serhii-matsyshyn/biolistener_hardware/README.md

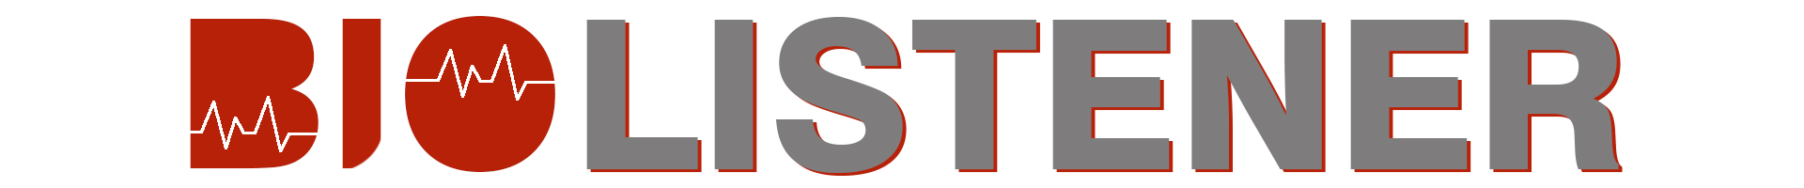
[picture p1: data/images/BioListener_Logo_1920х200.jpg]
BioListener Logo


# BioListener Hardware

This repository contains all the necessary files related to the **BioListener project** hardware design, including **PCB source files**, **schematic files**, **PCB layer visuals**, **fabrication files**, **BOM files**, and  **interactive BOM files**. The hardware designs are created in [EasyEDA](https://easyeda.com/), ensuring easy access and modification for further development.

## Evaluated Boards
The following boards are evaluated and tested as part of the BioListener project:

- **ADC AD7771** (Analog Devices)
- **ADC ADS131M08** (Texas Instruments)

## Included PCBs
### V1.0
Initial version of the BioListener boards.
- [**BioListener ADC AD7771-based Board v1.0**](hardware/pcb/V1.0/AD7771_V1.0) - 4 layer PCB
- [**BioListener ADC ADS131M08-based Board v1.0**](hardware/pcb/V1.0/ADS131M08_V1.0) - 4 layer PCB

### V1.1
Updated version of the BioListener boards. Changes: added voltage supervisor, minor improvements.
- [**BioListener ADC AD7771-based Board v1.1**](hardware/pcb/V1.1/AD7771_V1.1) - 4 layer PCB
- [**BioListener ADC ADS131M08-based Board v1.1**](hardware/pcb/V1.1/ADS131M08_V1.1) - 4 layer PCB

See schematic and PCB layer visuals in the PCBs folders as PDF documents.

## Included PCB Drafts
- **BioListener Stimulation Board v1.0** (Draft) - 4 layer PCB

### BioListener Boards v1.0

#### Ready PCBs (Prototypes)
<p align="center">
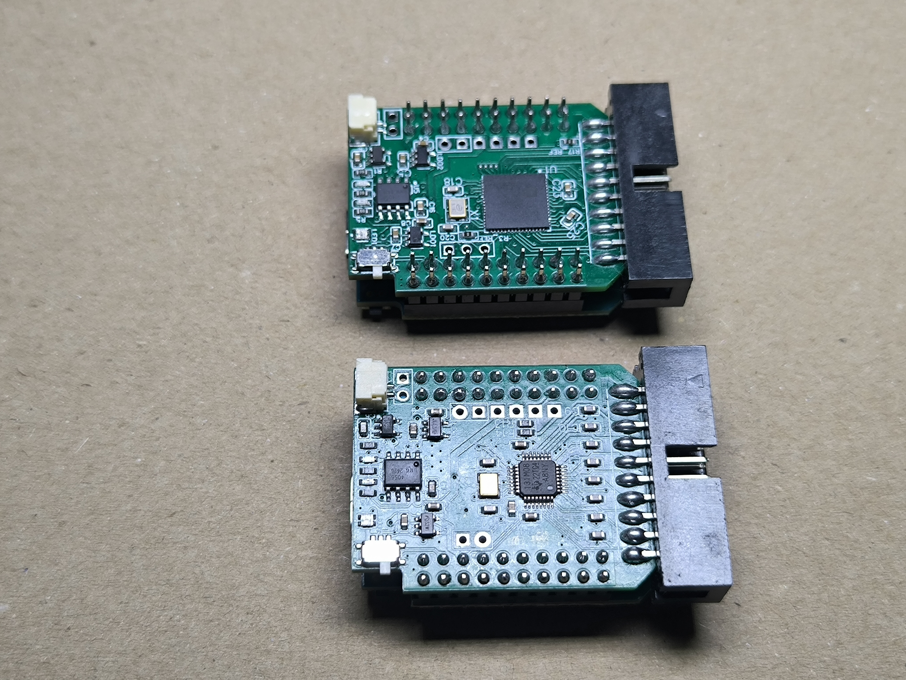
[picture p2: data/images/BioListener_boards_v1.0_prototypes.jpg]
BioListener Boards v1.0
  
</p>

<p align="center">
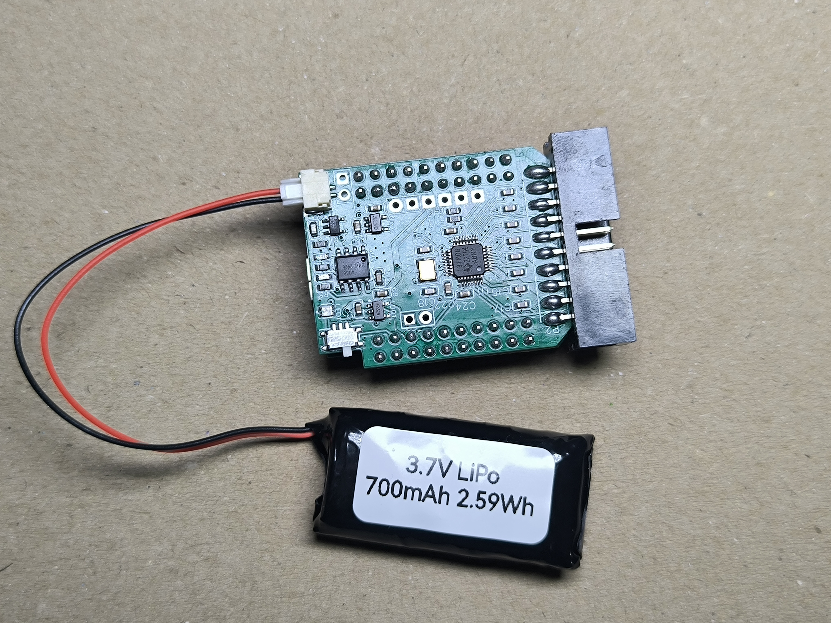
[picture p3: data/images/BioListener_boards_v1.0_prototypes_battery.jpg]
BioListener Boards v1.0
  
</p>

<p align="center">
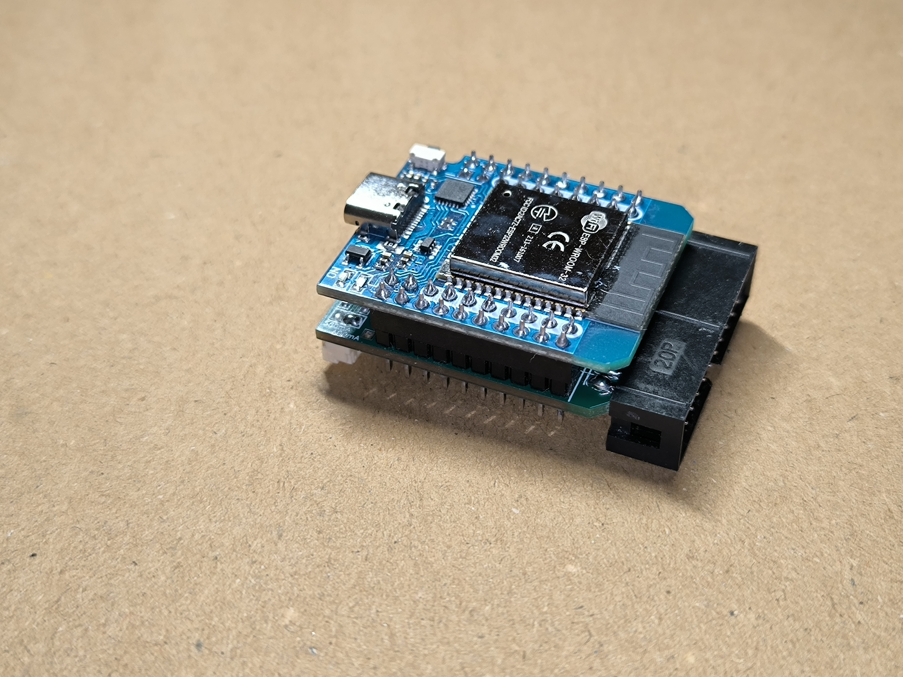
[picture p4: data/images/BioListener_boards_v1.0_esp32_prototypes.jpg]
BioListener Boards v1.0
  
</p>

#### Manual Assembly Process

| Step | Image |
|---|---|
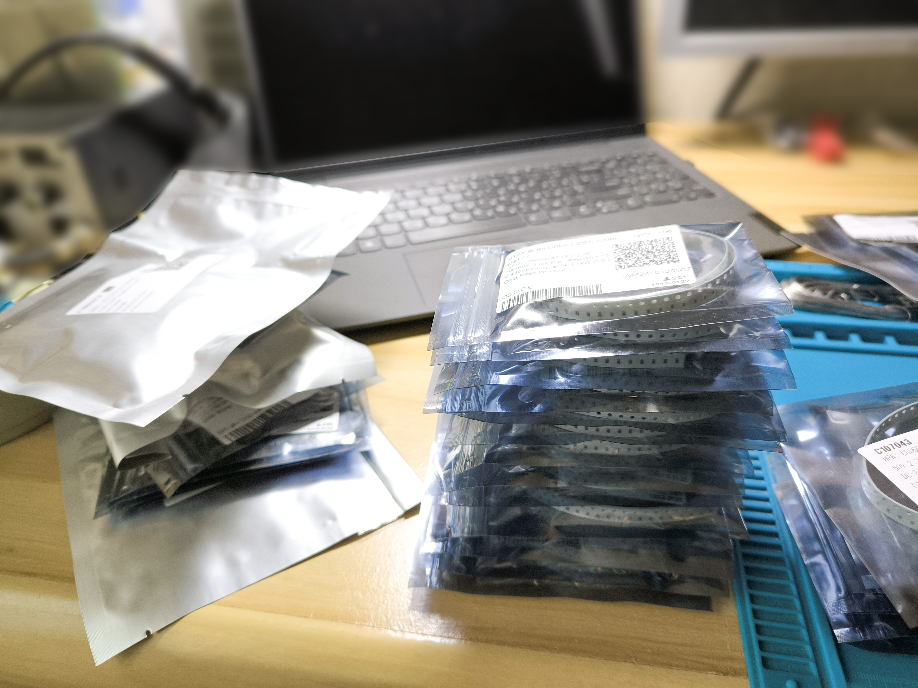
[picture p5: data/images/BioListener_pcb_components_1.jpg]
Components
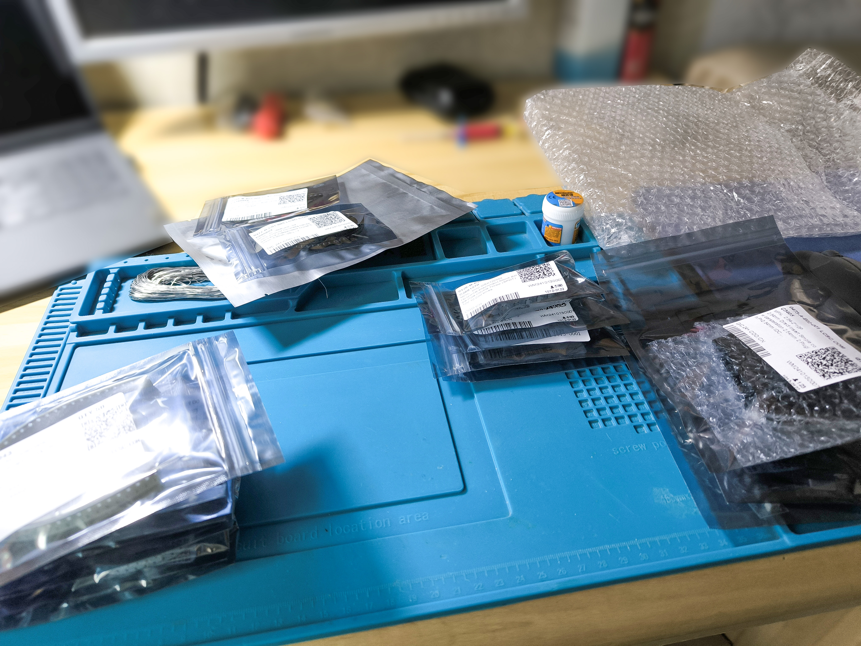
[picture p6: data/images/BioListener_pcb_components_2.jpg]
Components
| **1. Components** |   |
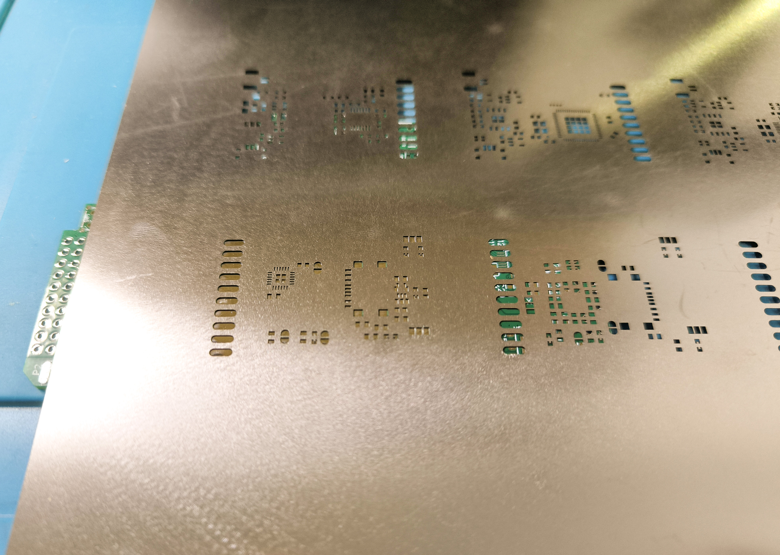
[picture p7: data/images/BioListener_pcb_stencil_1.jpg]
Stencil
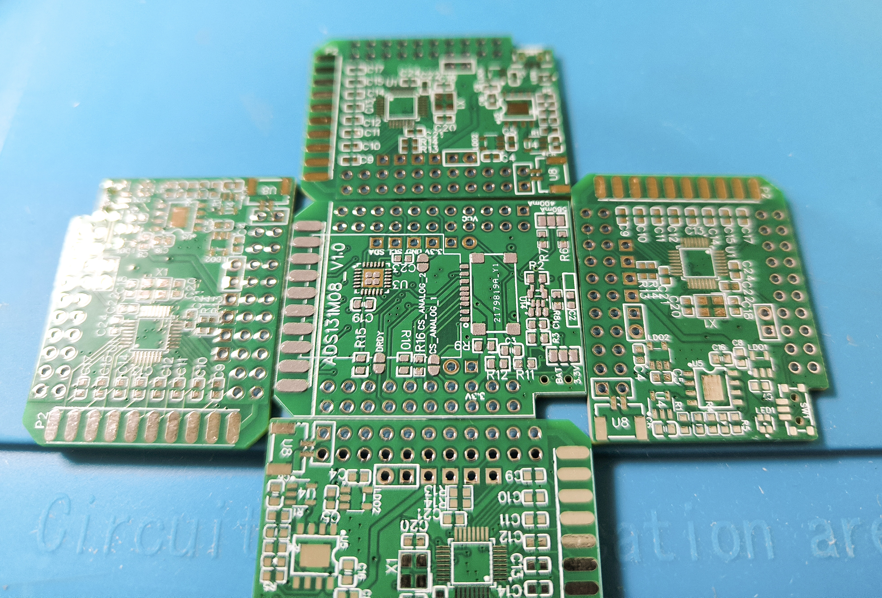
[picture p8: data/images/BioListener_pcb_stencil_2.jpg]
Stencil
| **2. Stencil, <br>Solder Paste applied** |   |
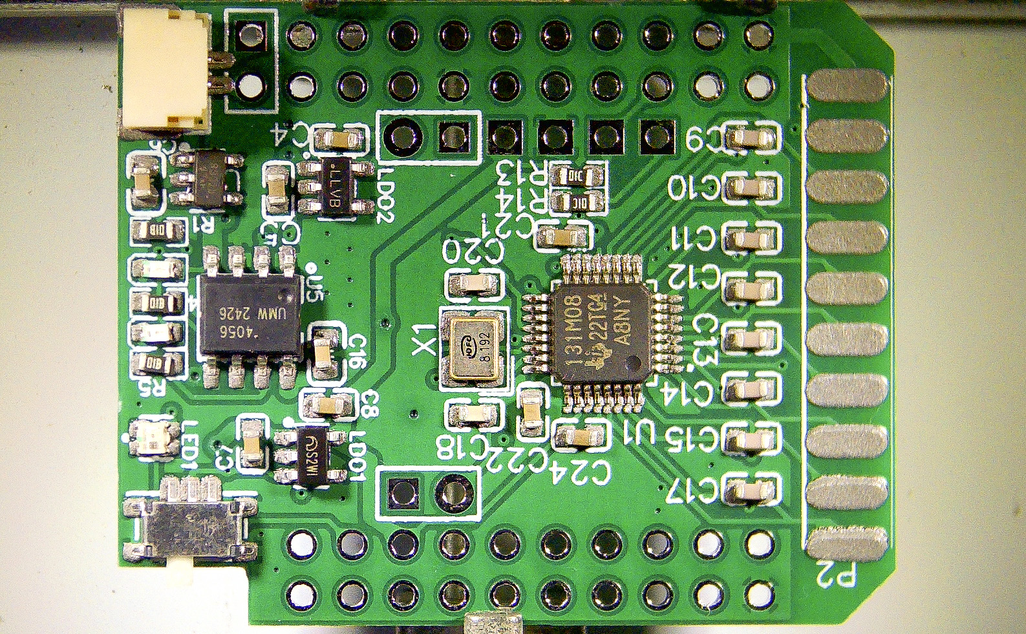
[picture p9: data/images/BioListener_pcb_populating.jpg]
Populating
| **3. Populating Under Microscope, <br>Hot Air Soldering** |  |
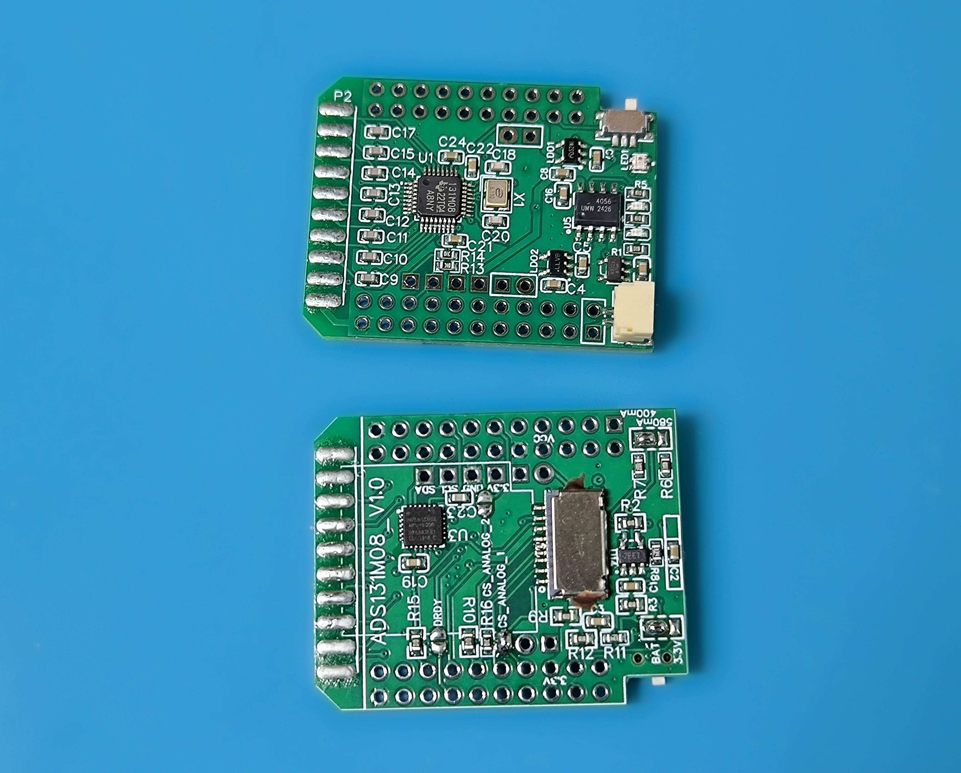
[picture p10: data/images/BioListener_pcb_ready.jpg]
Ready Boards
| **5. SMD Components Soldered** |  |
| **6. THD Connectors Soldered, <br>Boards Are Ready** | Ready Boards |

## License

This repository uses the following licenses:
- **Hardware design files** - The hardware design files in this repository are licensed under the **CERN Open Hardware Licence, Version 2 - Strongly Reciprocal**.
