serhii-matsyshyn/biolistener_hardware/hardware/pcb/V1.1/AD7771_V1.1/production/BOM_EEG_main_ad7771_2025-03-14.csv

ID | Name | Designator | Footprint | Quantity | Manufacturer Part | Manufacturer | Supplier | Supplier Part | Price
1 | 100n | C3,C6,C9,C12,C13,C15,C16,C22,C23,C25,C26,C28,C30,C32,C34 | C_0603 | 15 | CC0603KRX7R9BB104 | YAGEO | LCSC | C14663 | 0.002
2 | 1uF | C4,C5,C7,C8,C10,C11,C14,C17,C19,C27,C29,C31,C35 | C0603 | 13 | CL10A105KO8NNNC | SAMSUNG(三星) | LCSC | C1592 | 0.003
3 | 10pF | C18,C20 | C0603 | 2 | 0603CG100J500NT | FH(风华) | LCSC | C91367 | 0.003
4 | ME6211C33M5G-N | LDO1 | SOT-23-5_L3.0-W1.7-P0.95-LS2.8-BL | 1 | ME6211C33M5G-N | MICRONE(南京微盟) | LCSC | C82942 | 0.048
5 | LP5907MFX-3.3/NOPB | LDO2 | SOT-23-5_L3.0-W1.7-P0.95-LS2.8-BR | 1 | LP5907MFX-3.3/NOPB | TI(德州仪器) | LCSC | C80670 | 0.102
6 | XL-1615RGBC-WS2812B | LED1 | LED-SMD_4P-L1.6-W1.5_XL-1615RGBC-WS2812B | 1 | XL-1615RGBC-WS2812B | XINGLIGHT(成兴光) | LCSC | C5349954 | 0.049
7 | GREEN | LED5 | LED0603-RD_GREEN | 1 | XL-1608UGC-04 | XINGLIGHT(成兴光) | LCSC | C965804 | 0.005
8 | RED | LED6 | LED0603-RD_RED | 1 | XL-1608SURC-06 | XINGLIGHT(成兴光) | LCSC | C965799 | 0.003
9 | HDR-IDC-2.54-2X10P | P2 | EDGECONNECTOR_10X2X2.54 | 1 | IDC Box 2.54mm 2X10P Straight | BOOMELE | LCSC | C3405 | 0.119
10 | 1kΩ | R1,R4,R5 | R0603 | 3 | 0603WAF1001T5E | UNI-ROYAL(厚声) | LCSC | C21190 | 0.001
11 | 0Ω | R2_REF,R3_REF,R17_REF | R0603 | 3 | 0603WAF0000T5E | UNI-ROYAL(厚声) | LCSC | C21189 | 0.001
12 | 2kΩ | R6 | R0603 | 1 | 0603WAF2001T5E | UNI-ROYAL(厚声) | LCSC | C22975 | 0.001
13 | 3kΩ | R7 | R0603 | 1 | 0603WAF3001T5E | UNI-ROYAL(厚声) | LCSC | C4211 | 0.001
14 | 100k | R9,R10,R12,R15,R17 | 0603 | 5 | 0603WAF1003T5E | UNI-ROYAL(厚声) | LCSC | C25803 | 0.001
15 | 330kΩ | R11 | R0603 | 1 | 0603WAF3303T5E | UNI-ROYAL(厚声) | LCSC | C23137 | 0.001
16 | 10kΩ | R13,R14,R16 | R0603 | 3 | 0603WAF1002T5E | UNI-ROYAL(厚声) | LCSC | C25804 | 0.001
17 | MINI MSK12CO2 | SW1 | SW-SMD_MSK12CO2 | 1 | MINI MSK12CO2 | SHOU HAN(首韩) | LCSC | C2681570 | 0.141
18 | AD7771BCPZ-RL | U1 | LFCSP-64_L9.0-W9.0-P0.50-BL-EP7.5 | 1 | AD7771BCPZ-RL | ADI(亚德诺) | LCSC | C651536 | 17.039
19 | RY2201 | U4 | SOT-23-5_L3.0-W1.7-P0.95-LS2.8-BL | 1 | RY2206 | RYCHiP(蕊源) | LCSC | C2935408 | 0.087
20 | TP4056_C725790 | U5 | ESOP-8_L4.9-W3.9-P1.27-LS6.0-BL-EP | 1 | TP4056 | UMW(友台半导体) | LCSC | C725790 | 0.067
21 | TF-123-ARP9H17 | U7 | TF-SMD_TF-123-ARP9H15 | 1 | TF-123-ARP9H17 | XUNPU(讯普) | LCSC | C2982548 | 0.092
22 | SM02B-GHS-TB(LF)(SN) | U8 | CONN-SMD_SM02B-GHS-TB-LF-SN | 1 | SM02B-GHS-TB(LF)(SN) | JST | LCSC | C189893 | 0.096
23 | MAX809T | U11 | SOT-23-3_L2.9-W1.3-P1.90-LS2.4-BR | 1 | MAX809T | UMW(友台半导体) | LCSC | C347372 | 0.041
24 | 8.192MHz | X1 | CRYSTAL-SMD_4P-L3.2-W2.5-BL | 1 | 7B008192I01 | HD(浩都频率) | LCSC | C648988 | 0.161
