serhii-matsyshyn/biolistener_hardware/hardware/pcb/V1.1/ADS131M08_V1.1/Schematic_BioListener_ads131m08_v1.0.pdf

SM02B-GHS-TB(LF)(SN)

## OR MCP6V31UT-E/OT

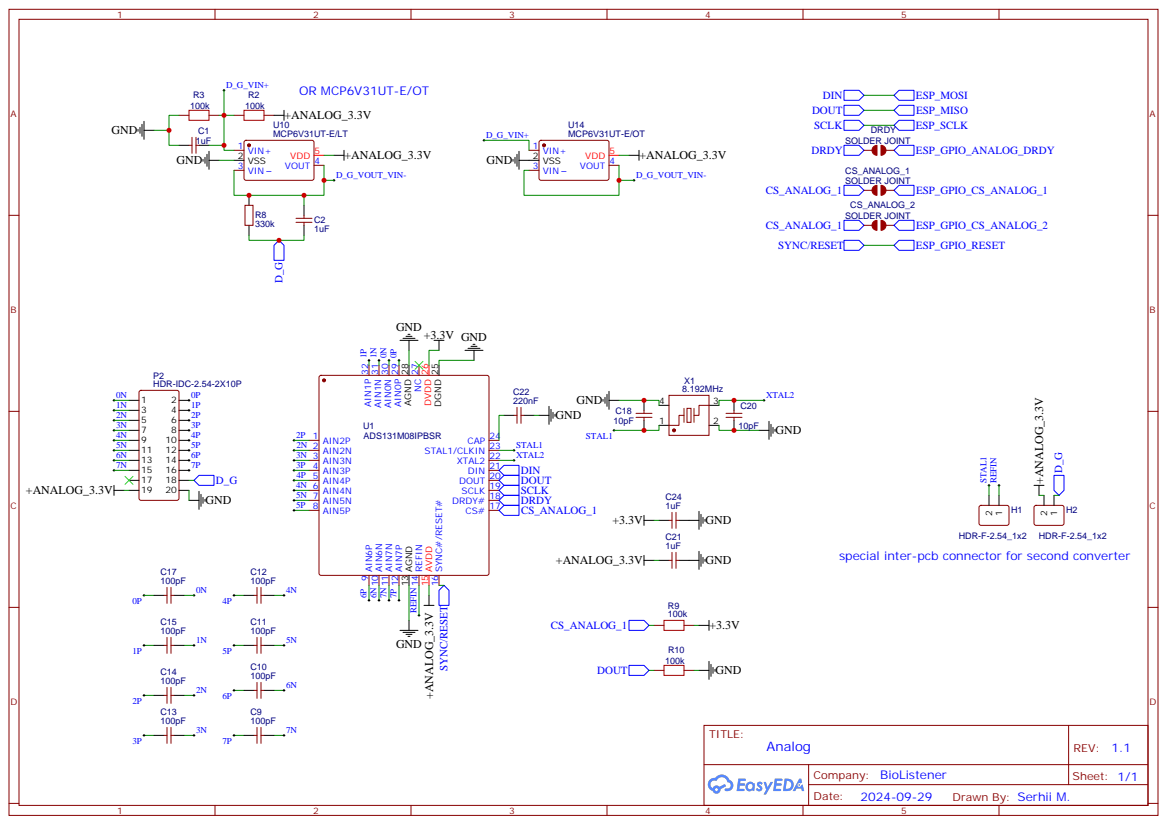
[picture p18: page 2]

CS# 17 DRDY# 18 SCLK 19 DOUT 20 DIN 21 XTAL2 22 STAL1/CLKIN 23 CAP 24 DGND ²⁵ DVDD ²⁶

special inter-pcb connector for second converter

## EMPTY

## EMPTY EMPTY

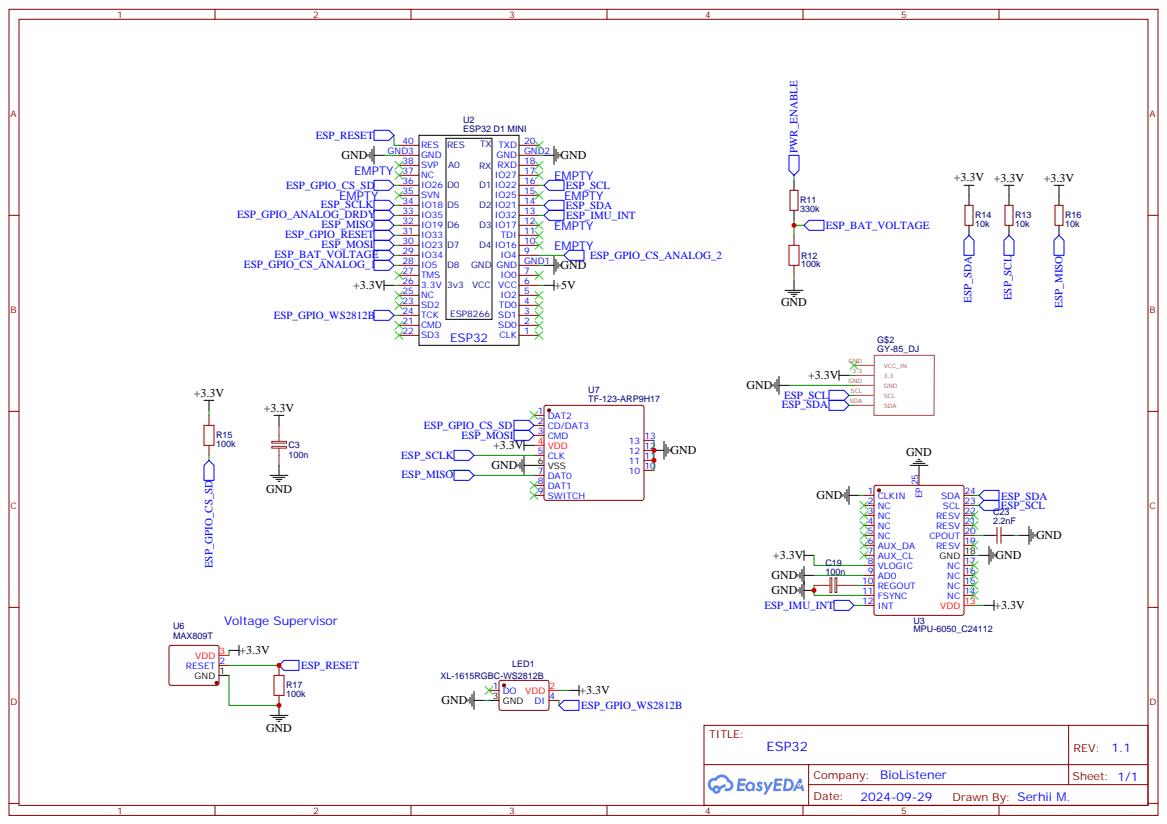
[picture p19: page 3]
