serhii-matsyshyn/biolistener_hardware/hardware/pcb/V1.1/ADS131M08_V1.1/pcb_layer_visuals/BottomSolderMaskLayer.pdf

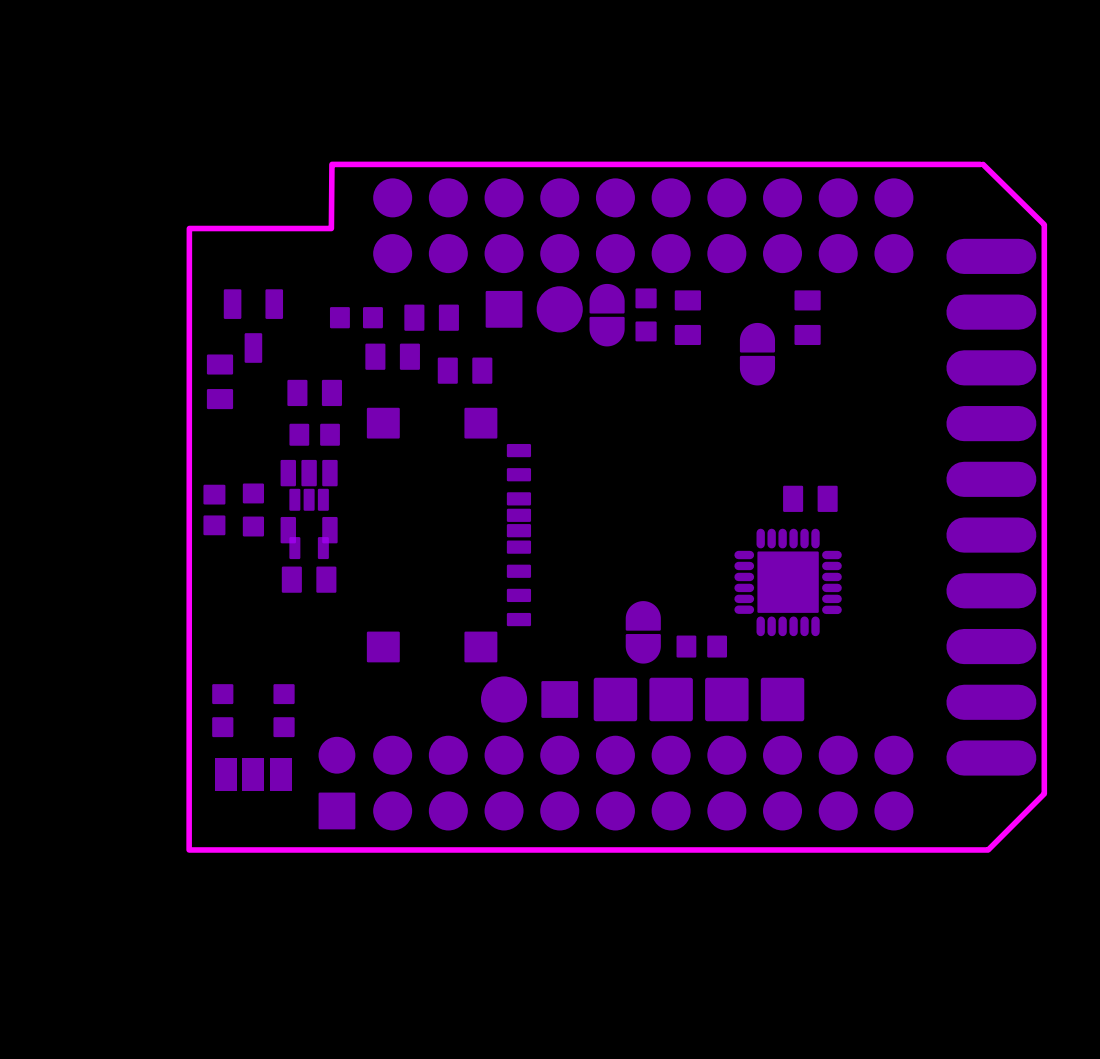
[picture p23: page 1]
