serhii-matsyshyn/biolistener_hardware/hardware/pcb/V1.0/AD7771_V1.0/Schematic_BioListener_ad7771_v1.0.pdf

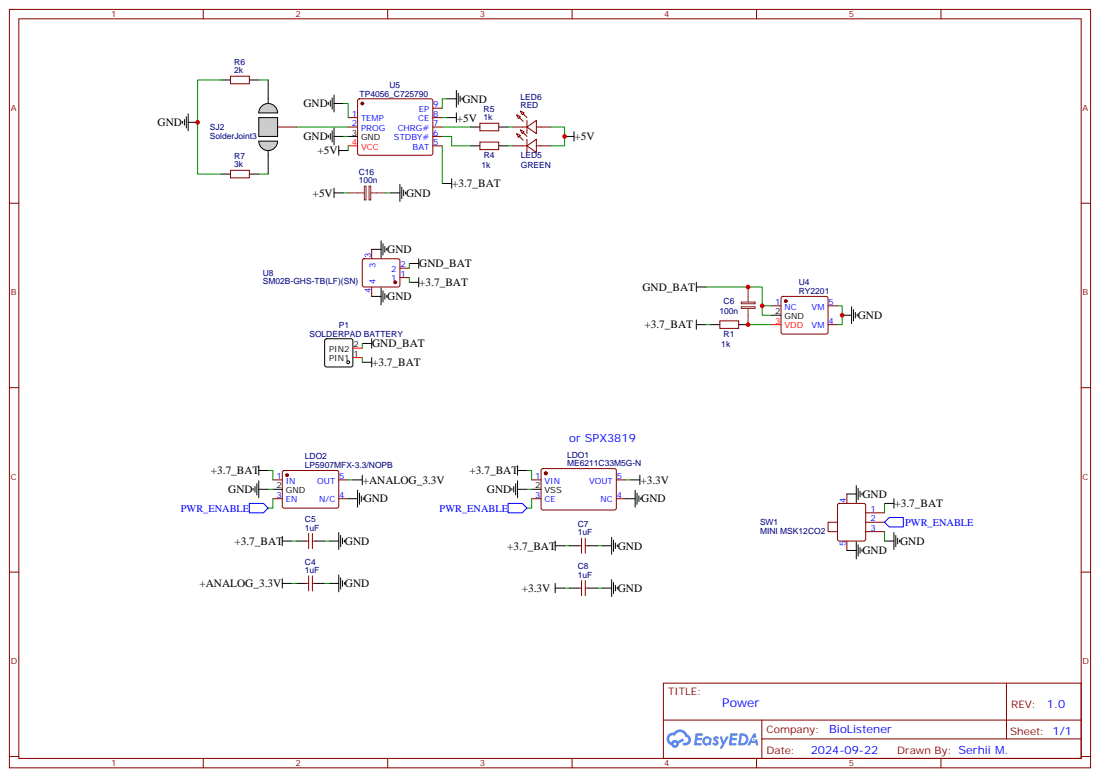
[picture p30: page 1]

SM02B-GHS-TB(LF)(SN)

# ESP_GPIO_CS_ANALOG_2 +ANALOG_3.3V

## External crystal generate

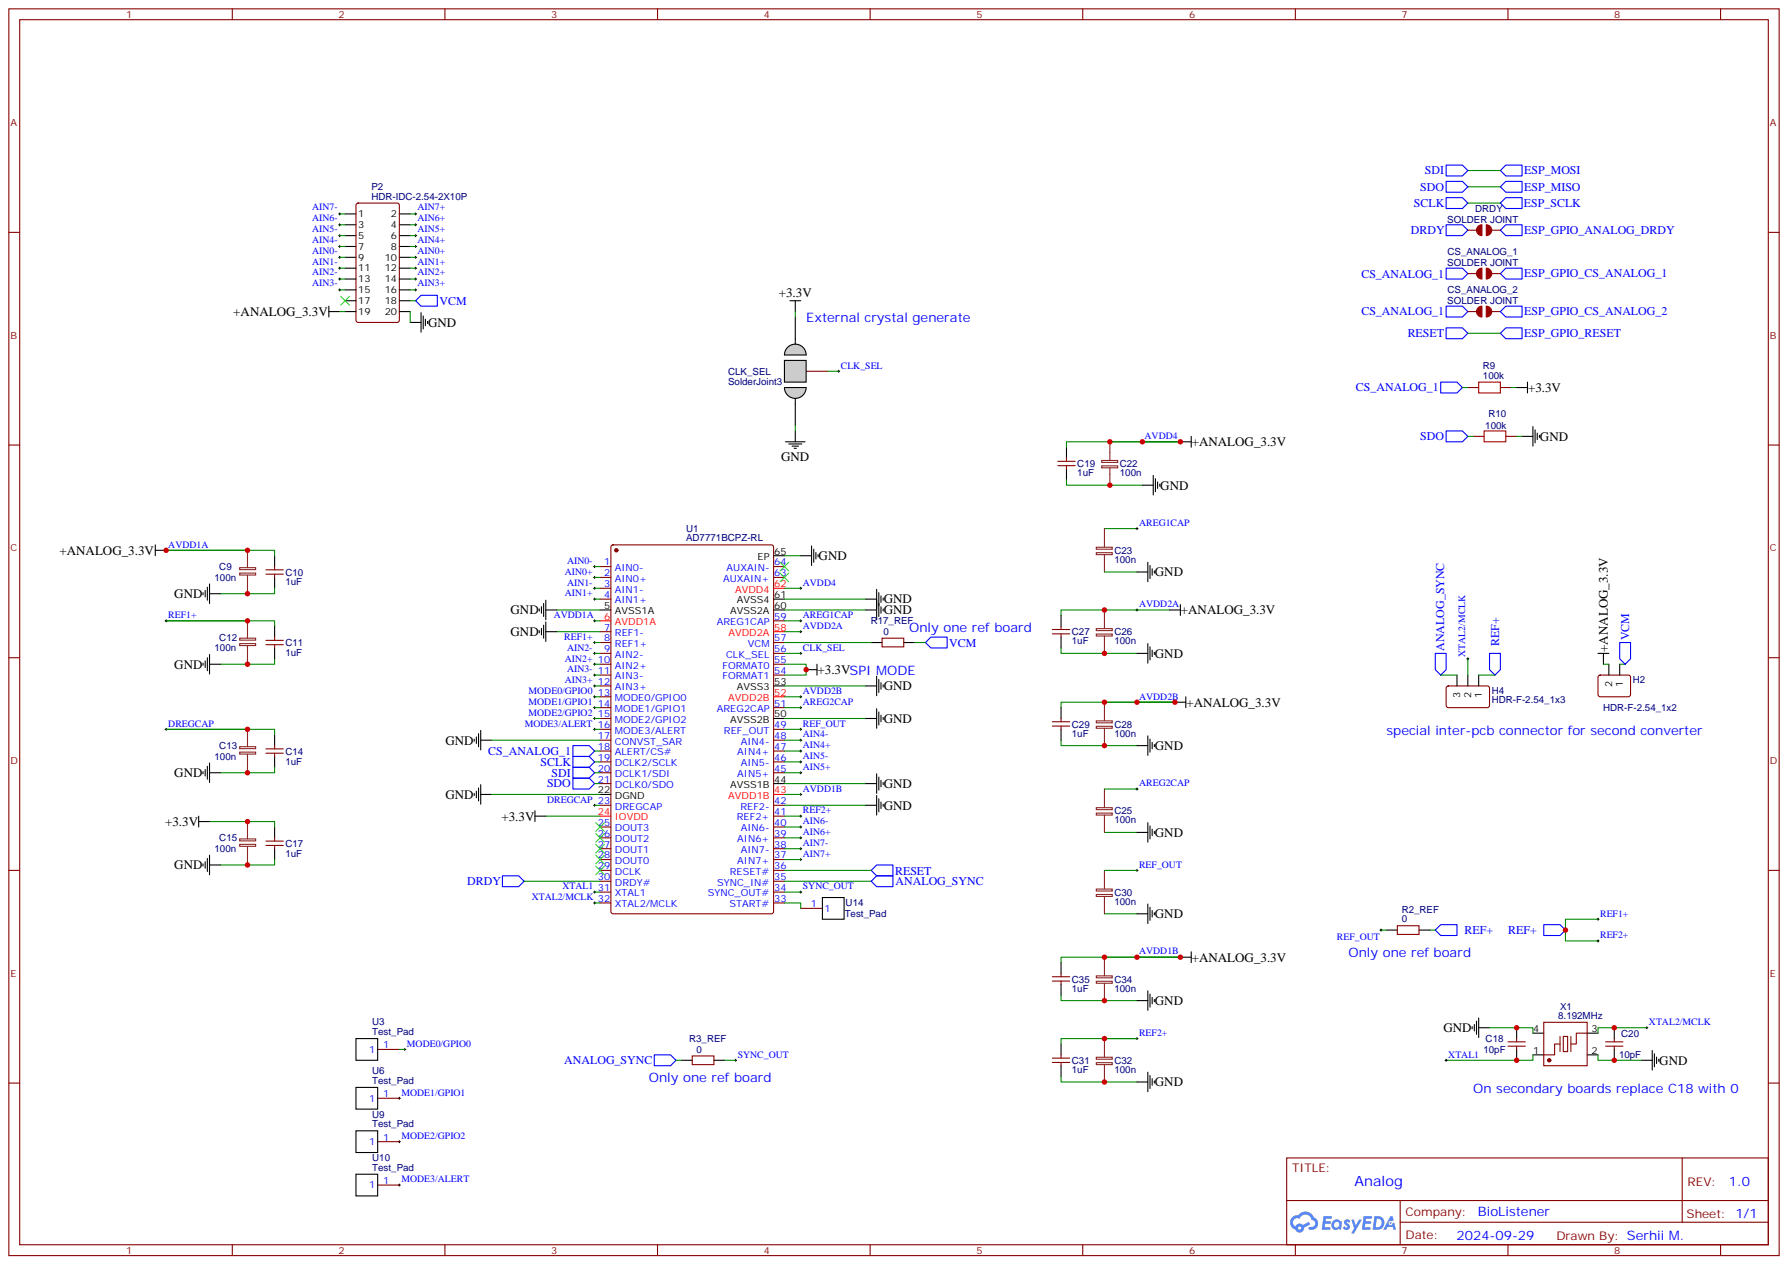
[picture p31: page 2]

special inter-pcb connector for second converter

REF_OUT
Only one ref board

On secondary boards replace C18 with 0

## EMPTY

## EMPTY

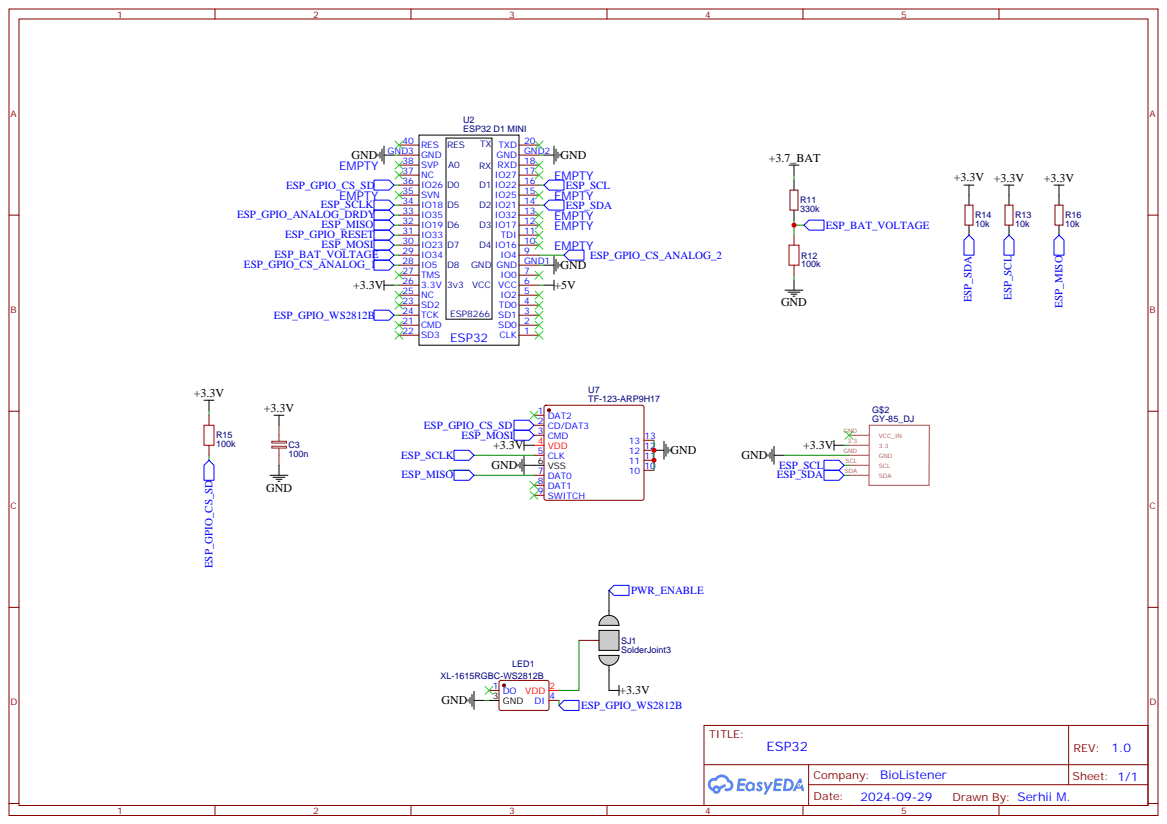
[picture p32: page 3]
