serhii-matsyshyn/biolistener_hardware/hardware/pcb/V1.0/ADS131M08_V1.0/Schematic_BioListener_ads131m08_v1.0.pdf

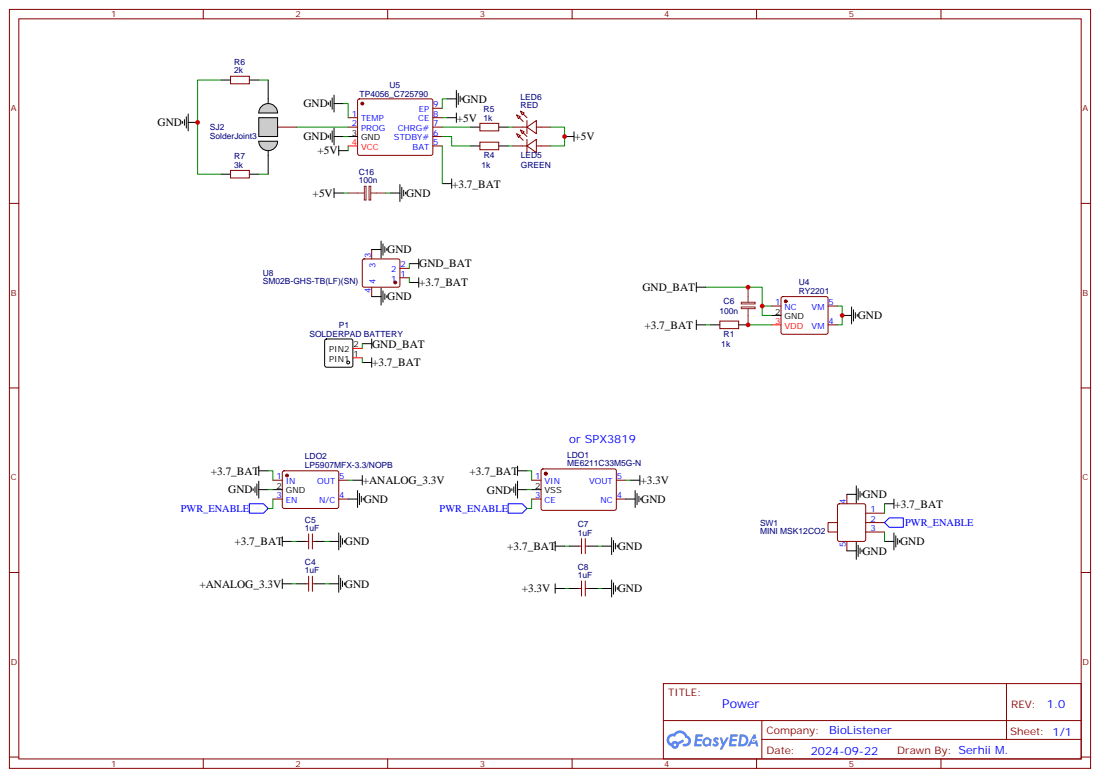
[picture p33: page 1]

SM02B-GHS-TB(LF)(SN)

## OR MCP6V31UT-E/OT

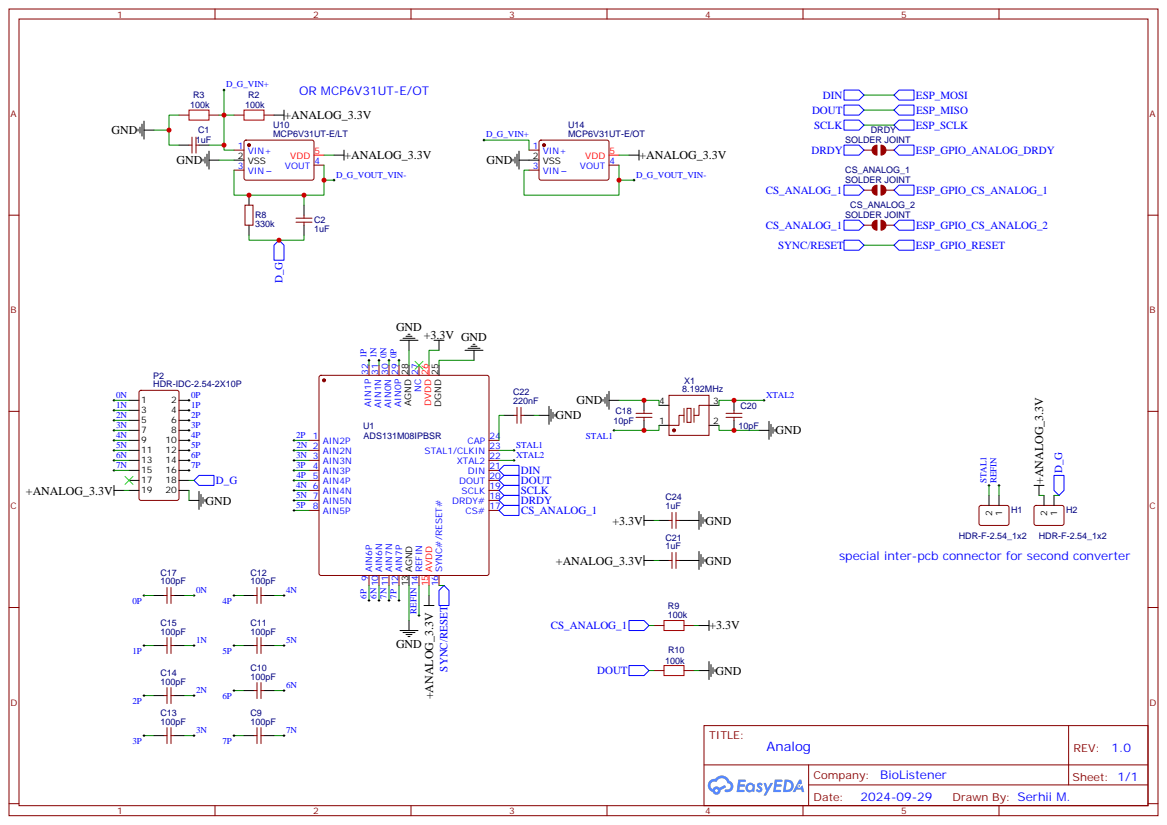
[picture p34: page 2]

CS# 17 DRDY# 18 SCLK 19 DOUT 20 DIN 21 XTAL2 22 STAL1/CLKIN 23 CAP 24 DGND ²⁵ DVDD ²⁶

special inter-pcb connector for second converter

## EMPTY

## EMPTY

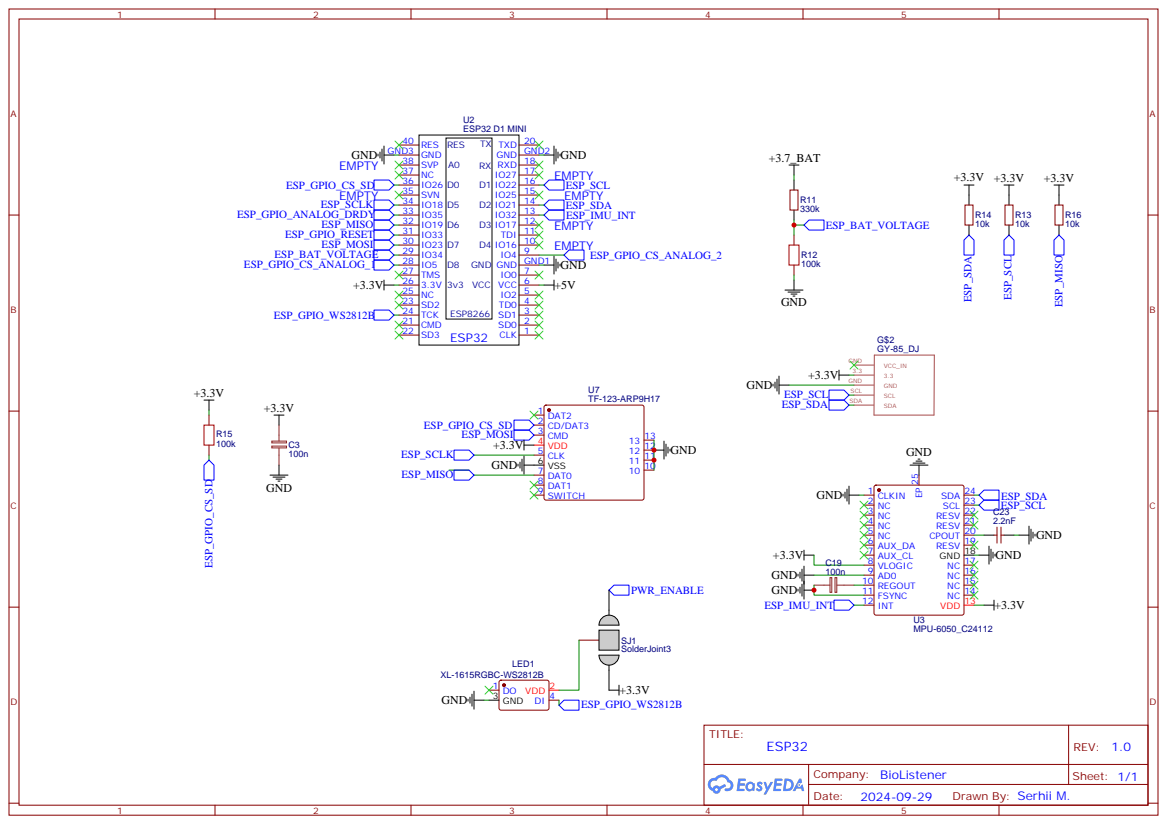
[picture p35: page 3]
