serhii-matsyshyn/biolistener_hardware/hardware/pcb/V1.0/STIMULATION_V1.0/pcb_layer_visuals/BottomLayer.pdf

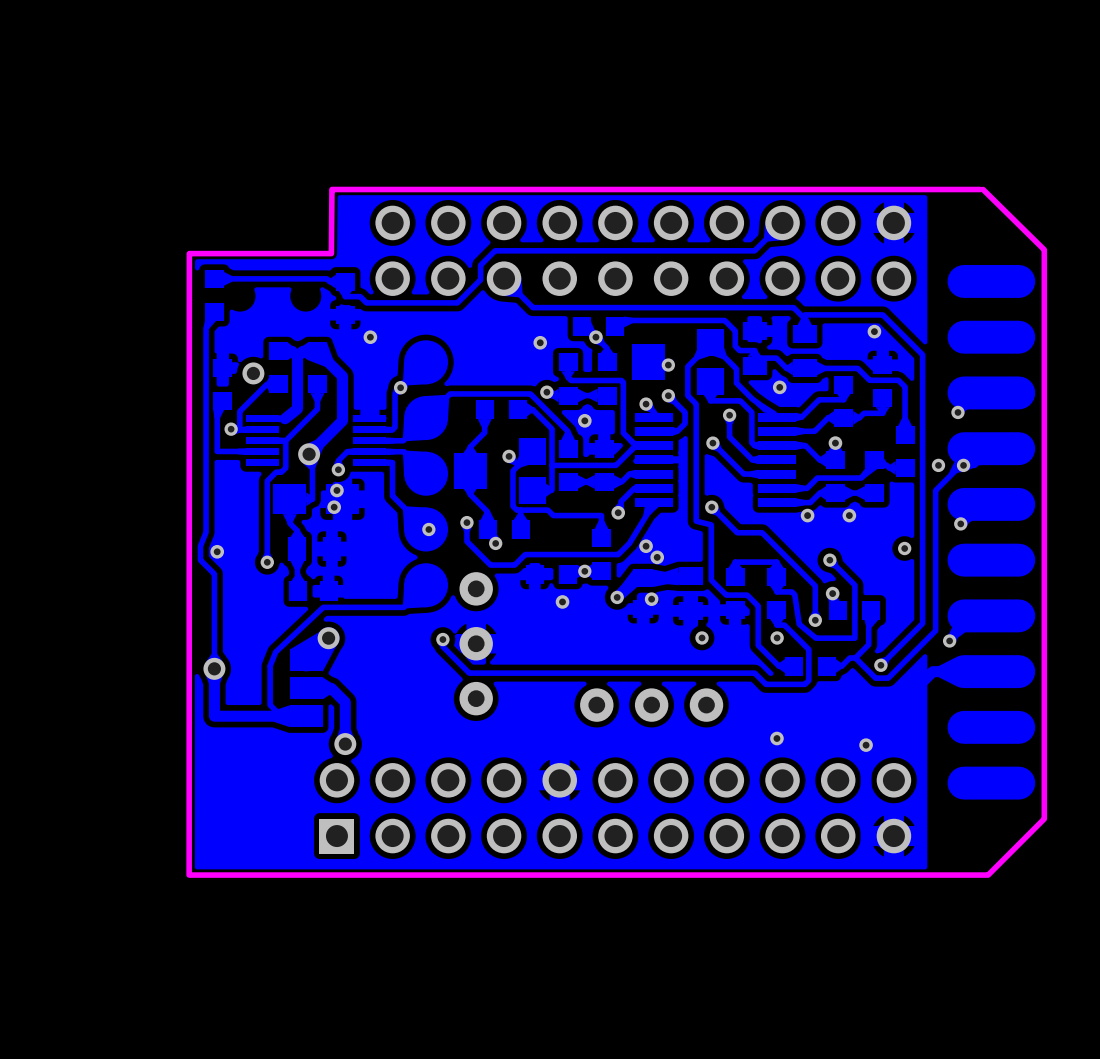
[picture p36: page 1]
