serhii-matsyshyn/biolistener_hardware/hardware/pcb/V1.0/STIMULATION_V1.0/pcb_layer_visuals/TopPasteMaskLayer.pdf

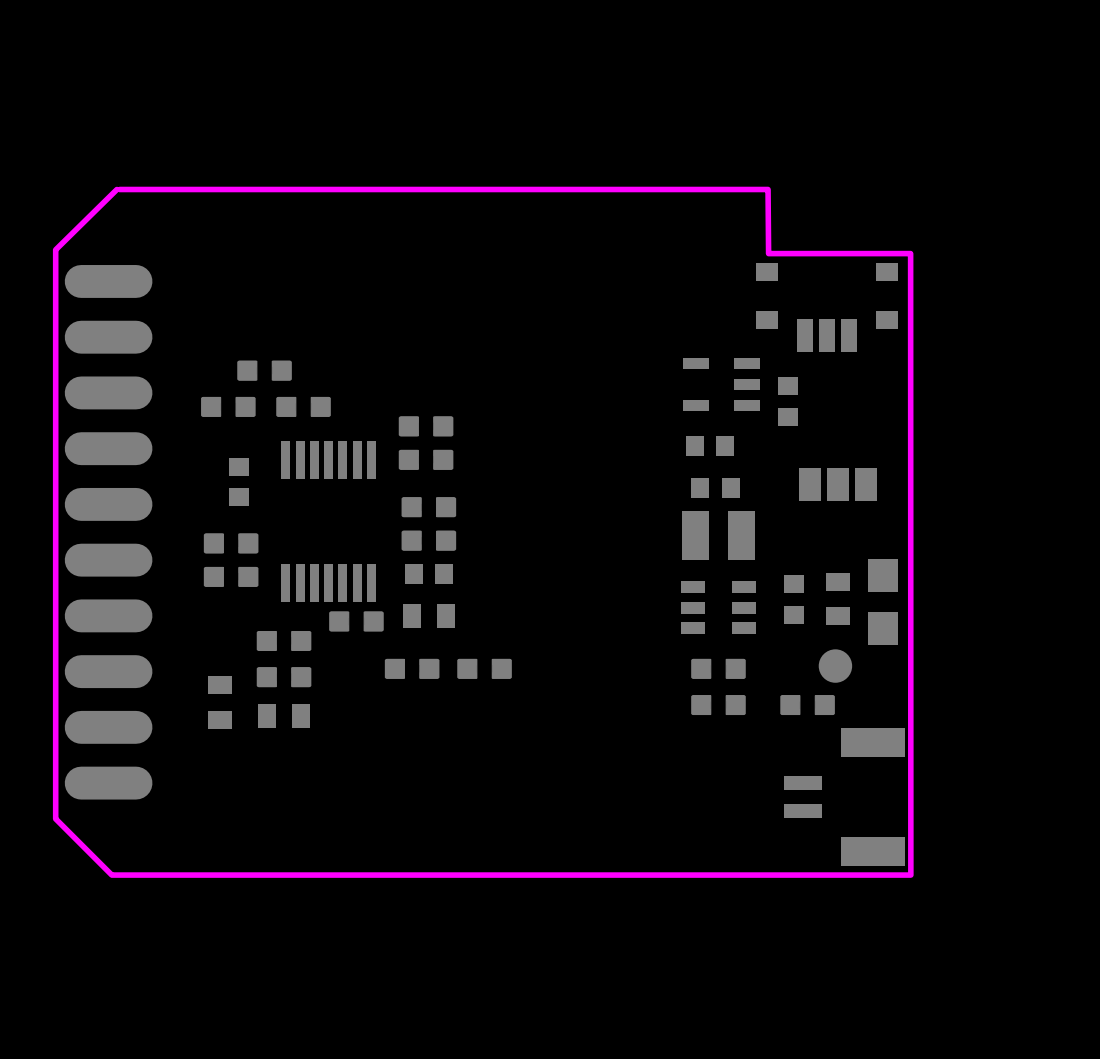
[picture p44: page 1]
