serhii-matsyshyn/biolistener_hardware/hardware/pcb/V1.1/AD7771_V1.1/pcb_layer_visuals/BottomSilkLayer.pdf

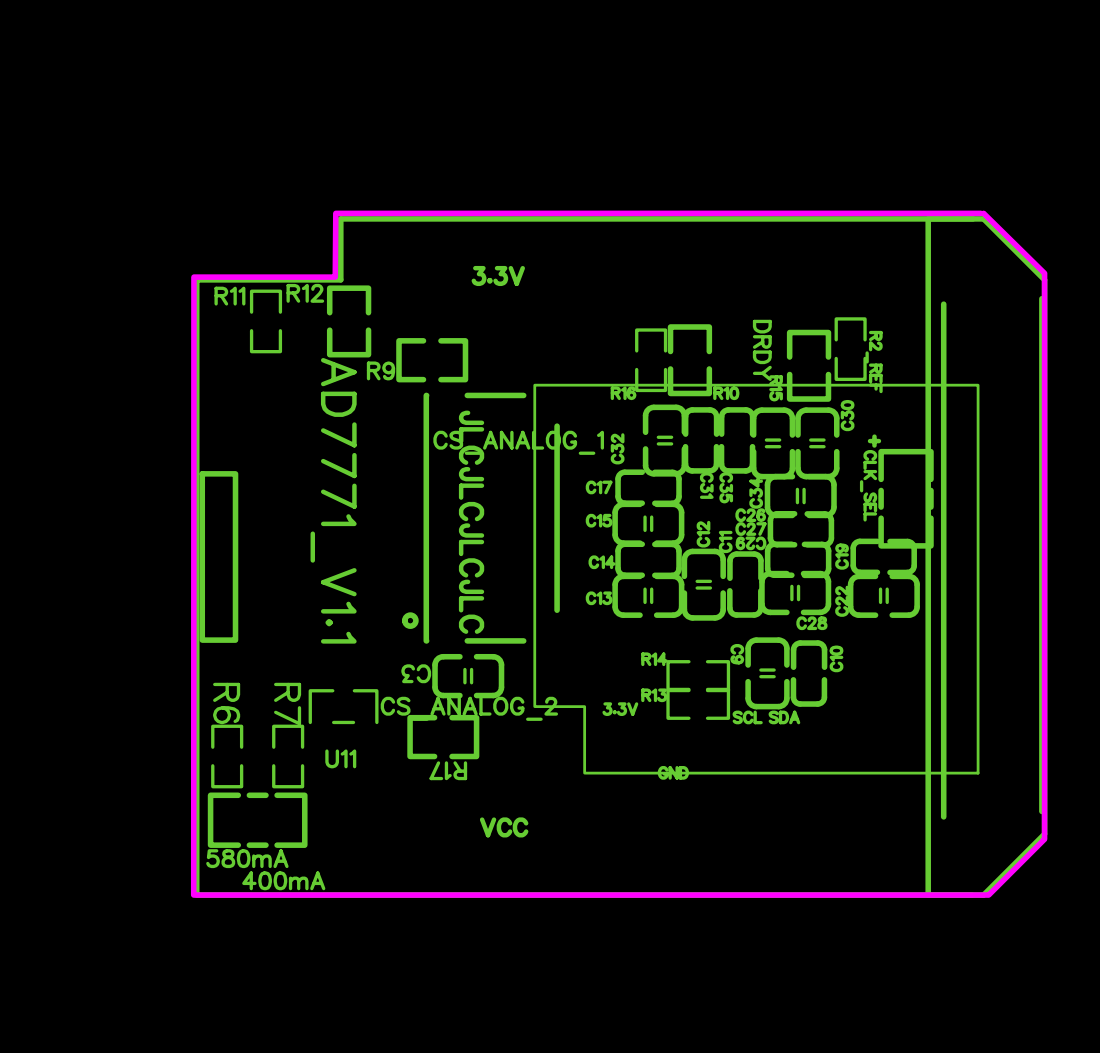
[picture p49: page 1]
