serhii-matsyshyn/biolistener_hardware/hardware/pcb/V1.1/AD7771_V1.1/pcb_layer_visuals/TopPasteMaskLayer.pdf

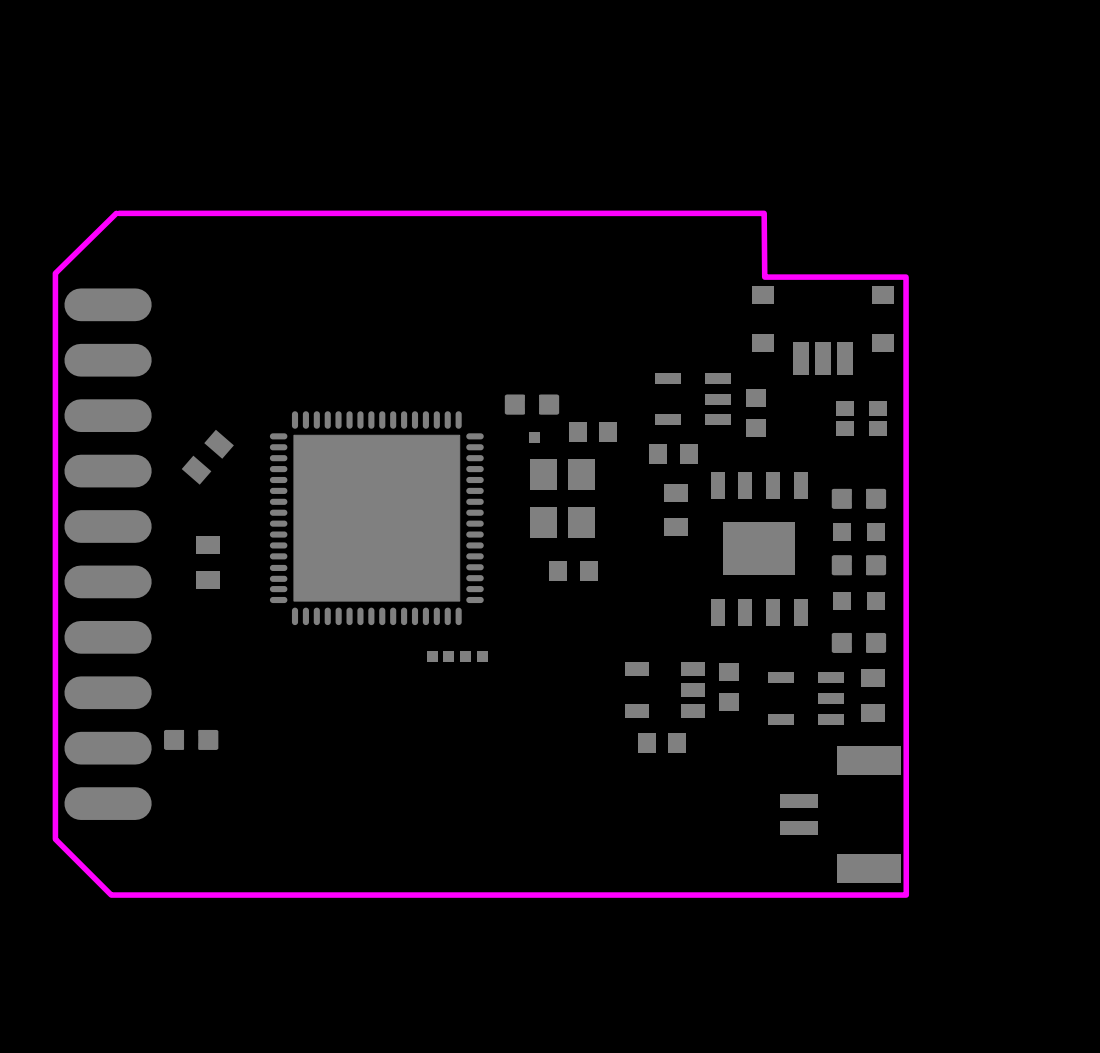
[picture p55: page 1]
