serhii-matsyshyn/biolistener_hardware/(commit log)

2025-01-12 added schematic
2025-03-14 Update PCB version path
    [BOM_EEG_main_2024-10-09.csv, BOM_EEG_main_ad7771_2024-10-10.csv, BOM_EEG_main_stimulation_2024-10-12.csv, PickAndPlace_PCB_EEG_main_2024-10-09.csv, PickAndPlace_PCB_EEG_main_ad7771_2024-10-10.csv, PickAndPlace_PCB_EEG_main_stimulation_2024-10-12.csv]
2025-03-15 BioListener boards V1.1
    [BOM_EEG_main_2025-03-14.csv, BOM_EEG_main_ad7771_2025-03-14.csv, PickAndPlace_PCB_EEG_main_2025-03-14.csv, PickAndPlace_PCB_EEG_main_ad7771_2025-03-14.csv]
2025-03-15 BioListener boards V1.1 - PCB layer visuals
